hotwolf/S12G-Micro-EVB/RevB/S12G-Micro-EVB RevB Schematic.pdf

A

A

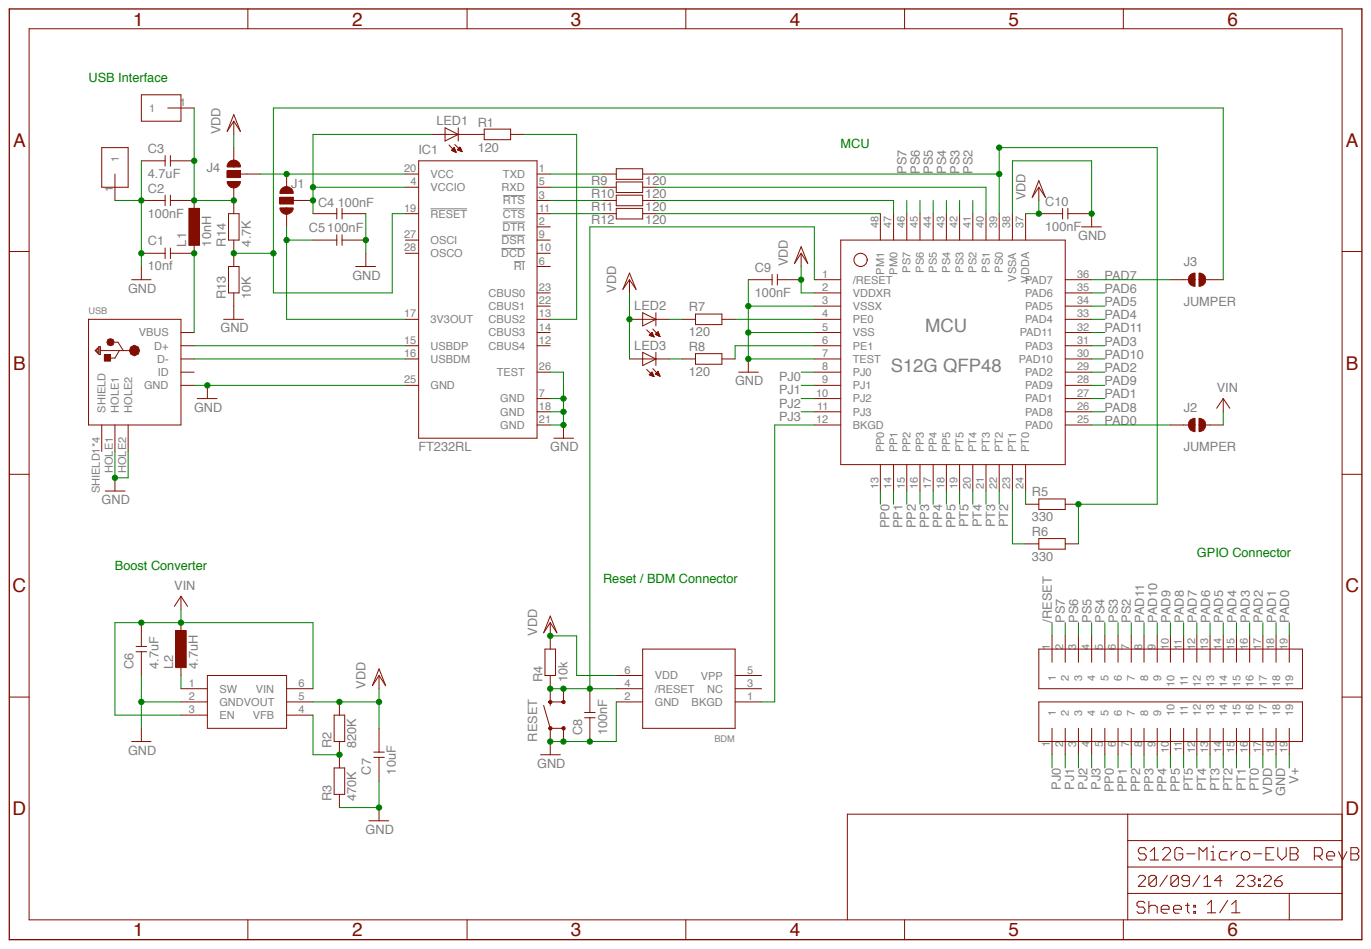
[picture p1: page 1]
