hotwolf/S12G-Micro-EVB/RevB/S12G-Micro-EVB RevB Mounting Plan.pdf

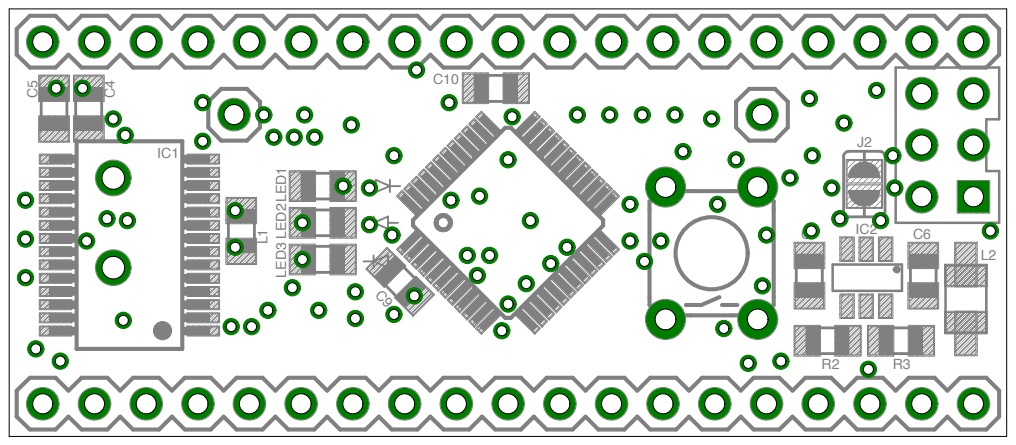
[picture p2: page 1]

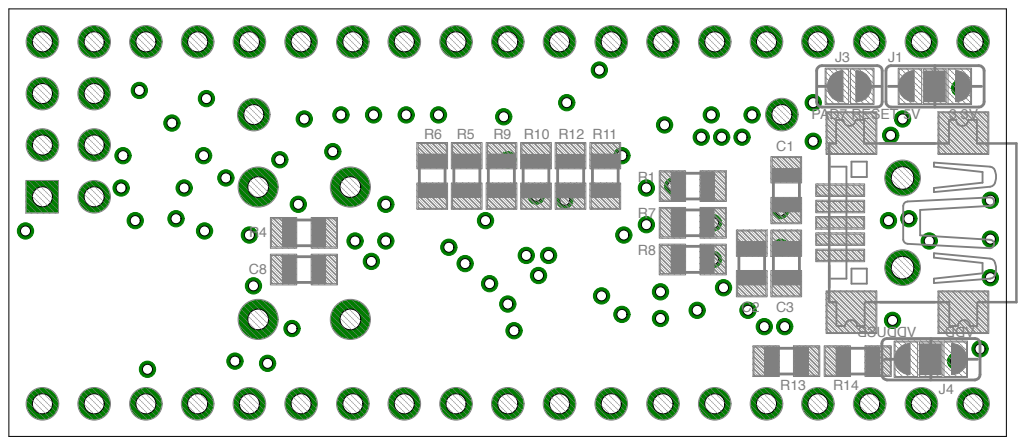
[picture p3: page 2]
