hotwolf/S12G-Micro-EVB/RevA/S12G-Micro-EVB RevA Schematic.pdf

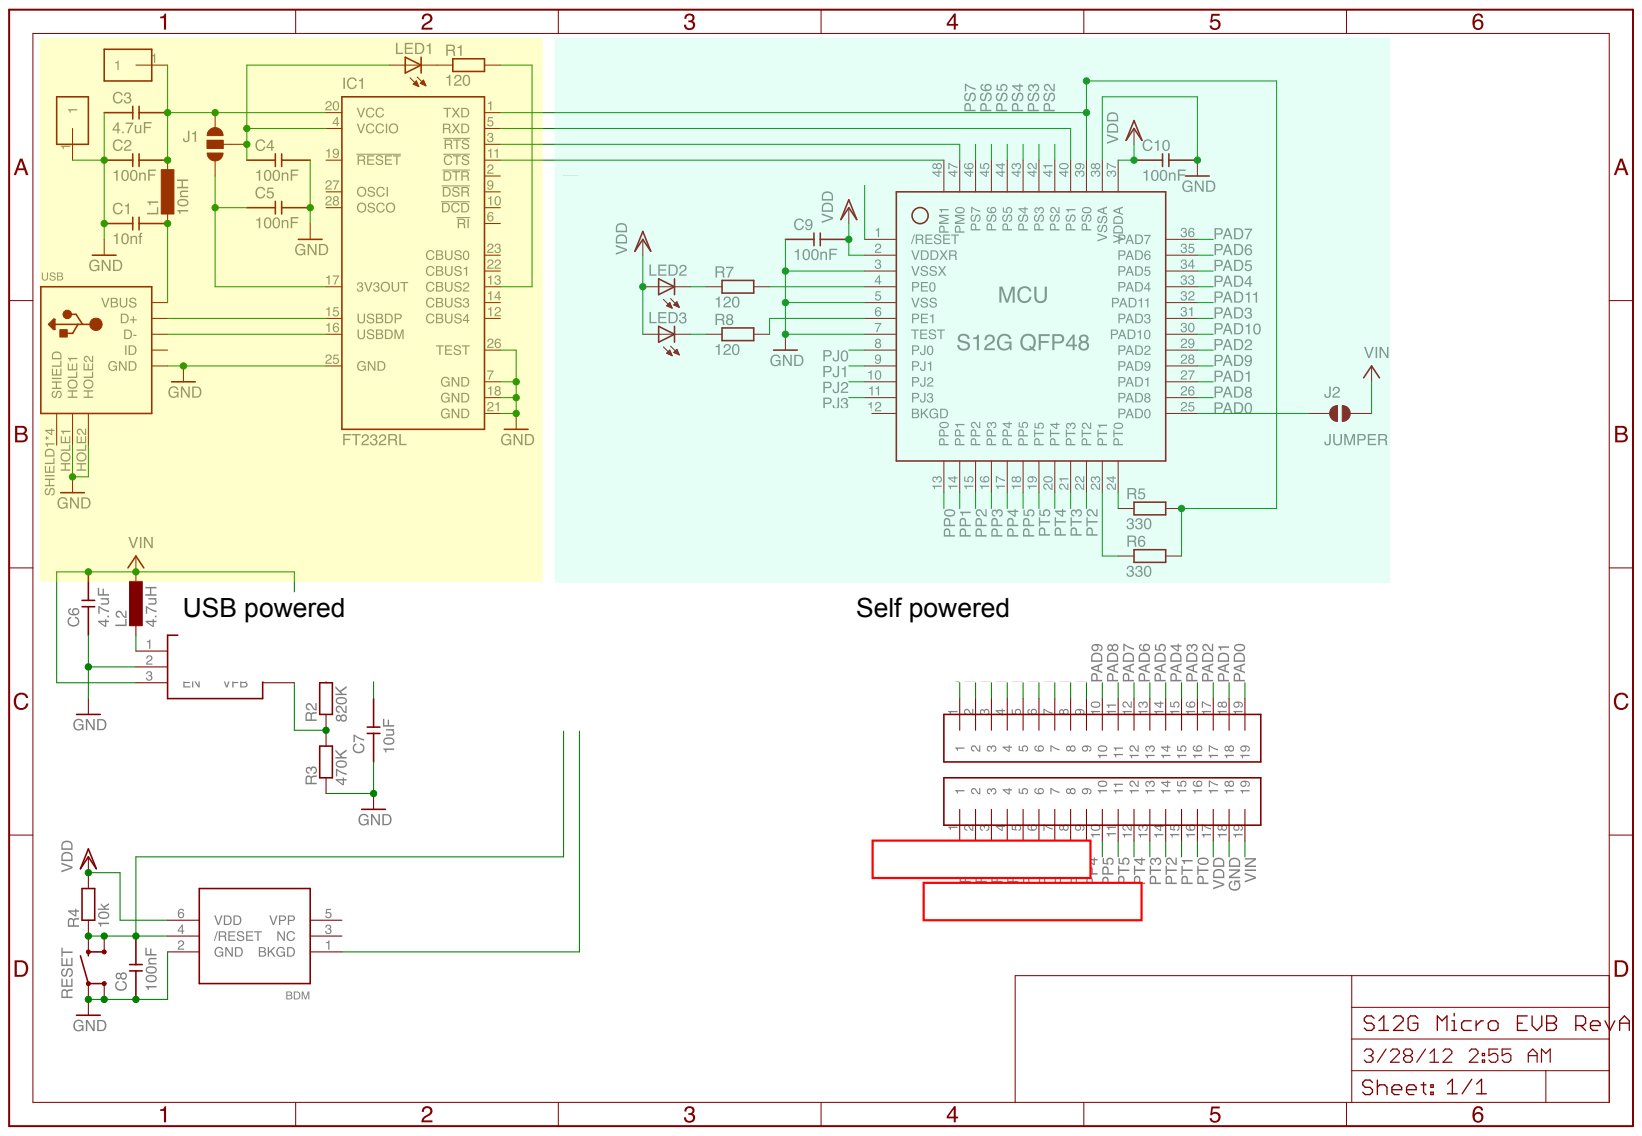
[picture p4: page 1]
