hotwolf/S12G-Micro-EVB/RevA/S12G-Micro-EVB RevA Mounting Plan.pdf

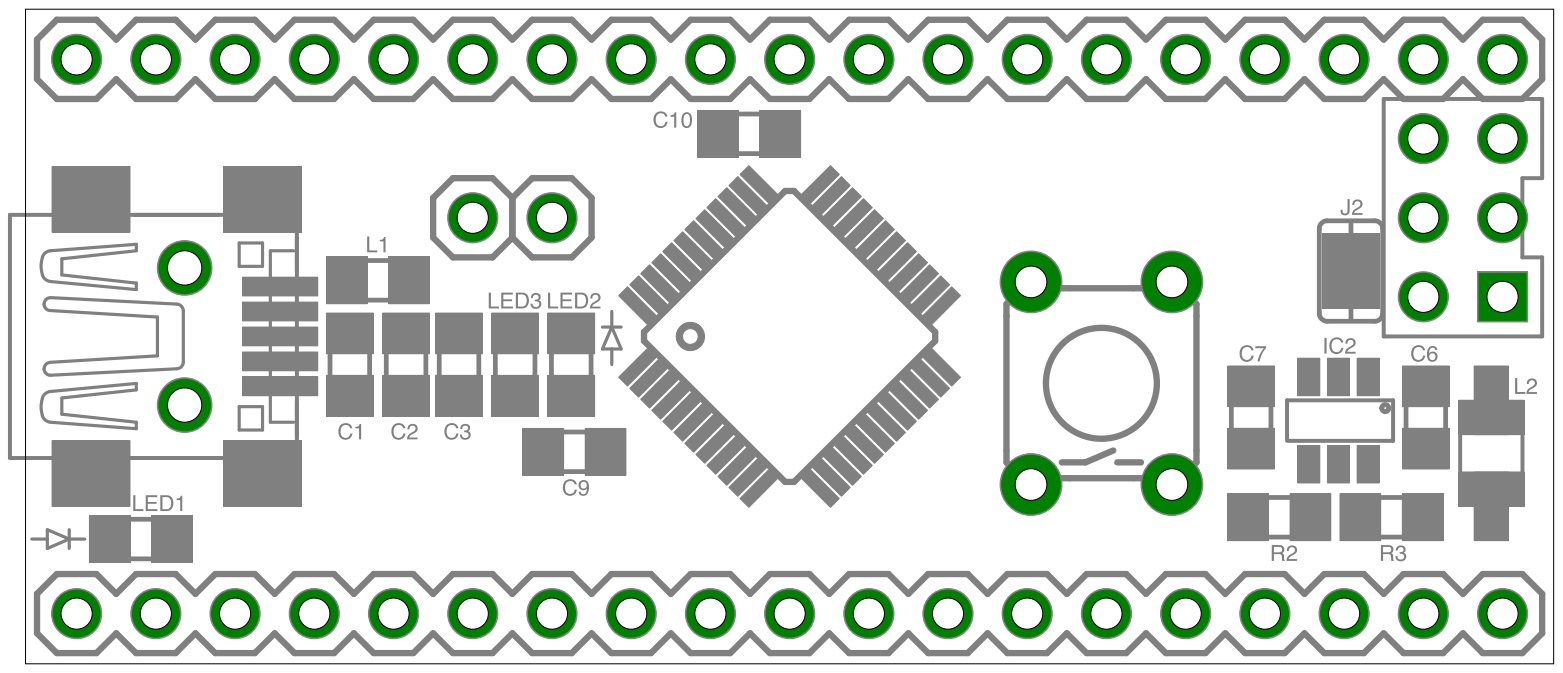
[picture p5: page 1]

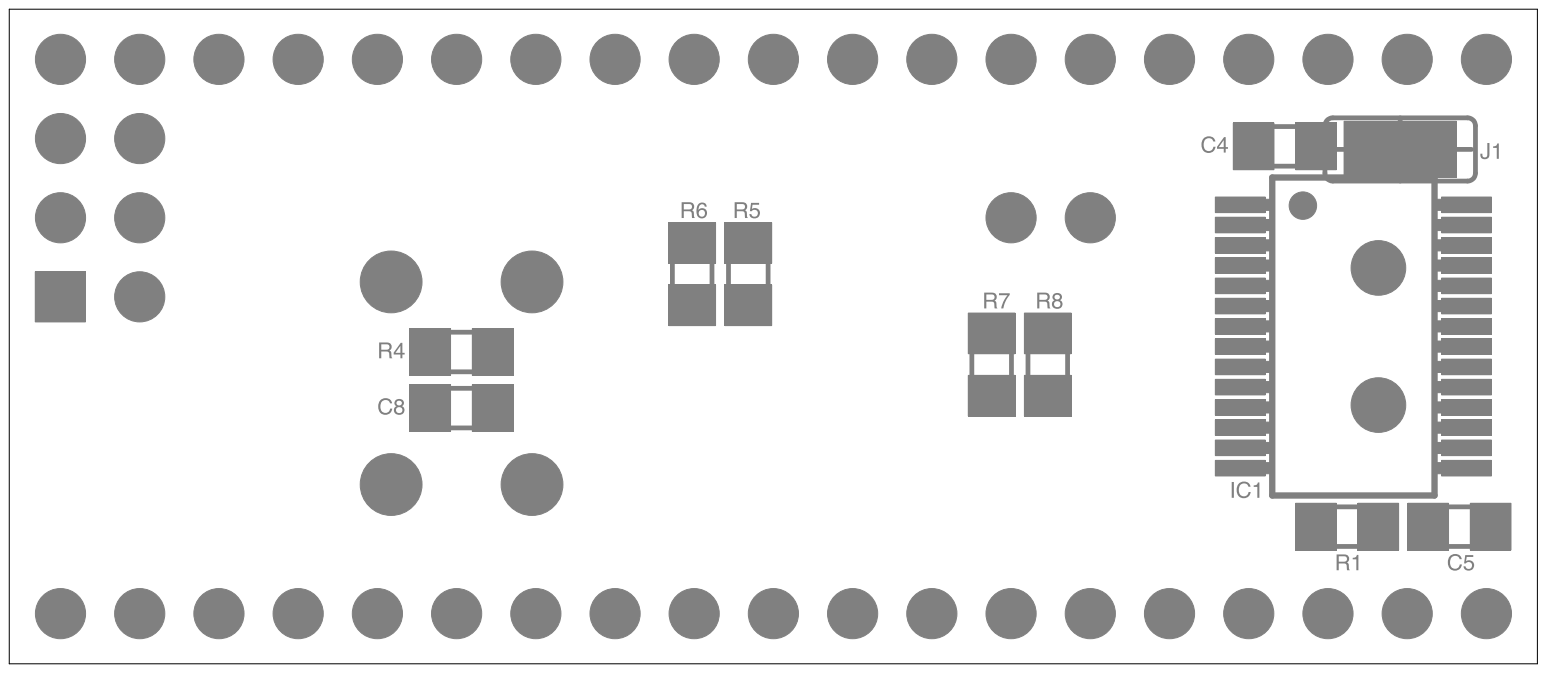
[picture p6: page 2]
