hotwolf/S12G-Micro-EVB/RevB/S12G-Micro-EVB RevB.brd

## EAGLE design RevB/S12G-Micro-EVB RevB.brd (2014-09-19)

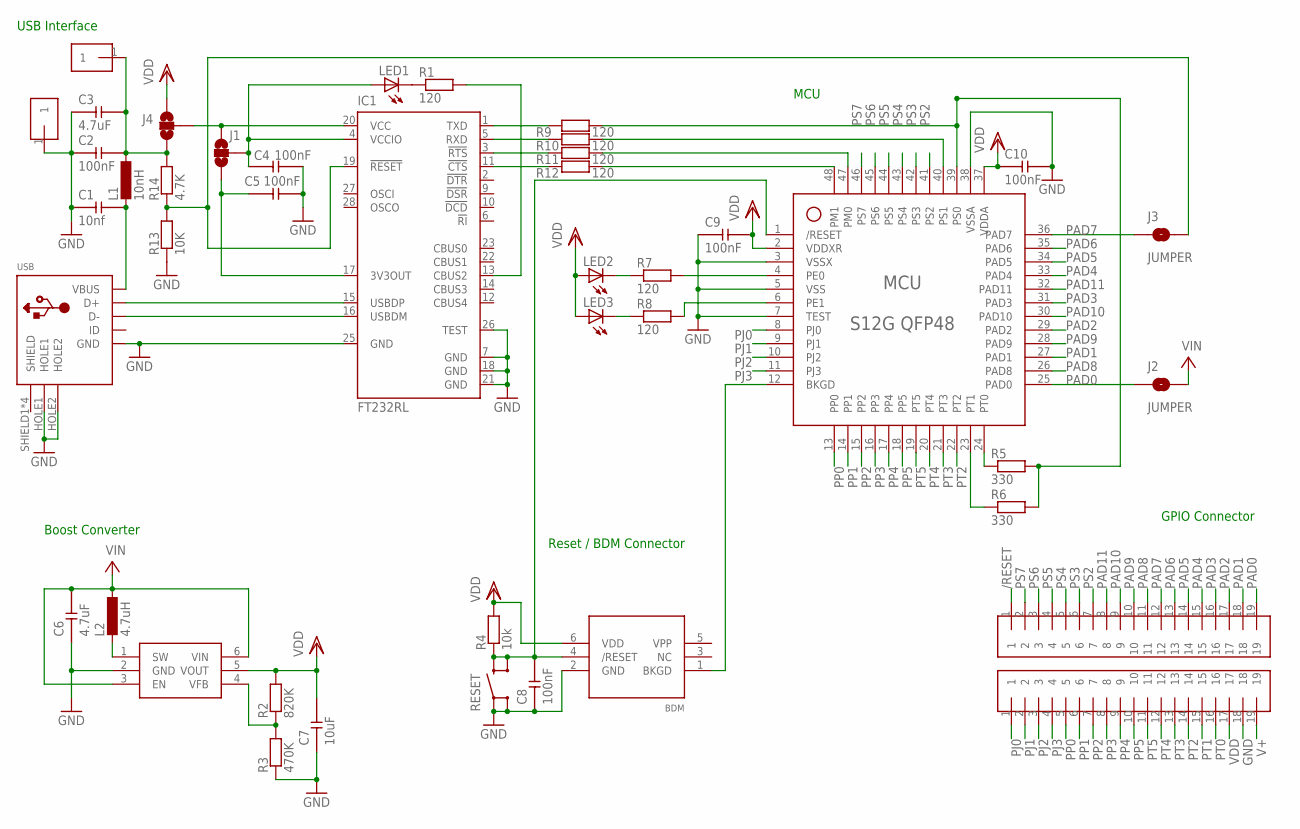
[picture p7: schematic S12G-Micro-EVB RevB.sch]

Parts:
BDM: BDM
BOTTOM: 1X19
C1: 10nf; 0805
C2, C4, C5, C8, C9, C10: 100nF; 0805
C3, C6: 4.7uF; 0805
C7: 10uF; 0805
GND: 1X1
IC1: FT232RL; SSOP28
IC2: MCP1640; SOT23-6
J1, J4: JUMPER_2WAY
J2, J3: JUMPER
L1: 10nH; 0805
L2: 4.7uH; LQH3C@1
LED1, LED2, LED3: LED0805; 0805
MCU: S12G QFP48; QFP44
R1, R7, R8, R9, R10, R11, R12: 120; 0805
R2: 820K; 0805
R3: 470K; 0805
R4: 10k; 0805
R5, R6: 330; 0805
R13: 10K; 0805
R14: 4.7K; 0805
RESET: BUTTON
TOP: 1X19
USB: USB; USB_MINI_B
VUSB: 1X1

Connections:
3V3OUT: C5.2, IC1.17 (3V3OUT), J1.3
/RESET: BDM.4 (/RESET), C8.1, MCU.1 (/RESET), R4.2, RESET.2, RESET.4, TOP.1
BKGD: BDM.1 (BKGD), MCU.12 (BKGD)
CBUS2: IC1.13 (CBUS2), R1.1
CTS: MCU.48 (PM1), R12.1
CTS_FT232RL: IC1.11 (!CTS), R12.2
GND: BDM.2 (GND), BOTTOM.18, C1.2, C2.2, C3.2, C4.1, C5.1, C6.2, C7.2, C8.2, C9.2, C10.1, GND.1, IC1.7 (GND), IC1.18 (GND), IC1.21 (GND), IC1.25 (GND), IC1.26 (TEST), IC2.2 (GND), MCU.3 (VSSX), MCU.5 (VSS), MCU.7 (TEST), MCU.38 (VSSA), R3.2, R13.2, RESET.1, RESET.3, USB.GND, USB.HOLE1, USB.HOLE2
unnamed: LED3.2 (C), R8.2
unnamed: IC2.4 (VFB), R2.2, R3.1
unnamed: LED2.2 (C), R7.2
unnamed: IC1.19 (!RESET), J3.2, R13.1, R14.2
unnamed: LED1.2 (C), R1.2
unnamed: IC2.1 (SW), L2.3 (2), L2.4 (2)
PAD0: J2.1, MCU.25 (PAD0), TOP.19
PAD1: MCU.27 (PAD1), TOP.18
PAD2: MCU.29 (PAD2), TOP.17
PAD3: MCU.31 (PAD3), TOP.16
PAD4: MCU.33 (PAD4), TOP.15
PAD5: MCU.34 (PAD5), TOP.14
PAD6: MCU.35 (PAD6), TOP.13
PAD7: J3.1, MCU.36 (PAD7), TOP.12
PAD8: MCU.26 (PAD8), TOP.11
PAD9: MCU.28 (PAD9), TOP.10
PAD10: MCU.30 (PAD10), TOP.9
PAD11: MCU.32 (PAD11), TOP.8
PE0: MCU.4 (PE0), R7.1
PE1: MCU.6 (PE1), R8.1
PJ0: BOTTOM.1, MCU.8 (PJ0)
PJ1: BOTTOM.2, MCU.9 (PJ1)
PJ2: BOTTOM.3, MCU.10 (PJ2)
PJ3: BOTTOM.4, MCU.11 (PJ3)
PP0: BOTTOM.5, MCU.13 (PP0)
PP1: BOTTOM.6, MCU.14 (PP1)
PP2: BOTTOM.7, MCU.15 (PP2)
PP3: BOTTOM.8, MCU.16 (PP3)
PP4: BOTTOM.9, MCU.17 (PP4)
PP5: BOTTOM.10, MCU.18 (PP5)
PS2: MCU.41 (PS2), TOP.7
PS3: MCU.42 (PS3), TOP.6
PS4: MCU.43 (PS4), TOP.5
PS5: MCU.44 (PS5), TOP.4
PS6: MCU.45 (PS6), TOP.3
PS7: MCU.46 (PS7), TOP.2
PT0: BOTTOM.16, MCU.24 (PT0), R5.2
PT1: BOTTOM.15, MCU.23 (PT1), R6.2
PT2: BOTTOM.14, MCU.22 (PT2)
PT3: BOTTOM.13, MCU.21 (PT3)
PT4: BOTTOM.12, MCU.20 (PT4)
PT5: BOTTOM.11, MCU.19 (PT5)
RTS: MCU.47 (PM0), R11.1
RTS_FT232RL: IC1.3 (!RTS), R11.2
RXD: MCU.39 (PS0), R5.1, R6.1, R9.1
RXD_FT232RL: IC1.5 (RXD), R10.2
SHIELD: USB.SHIELD1 (SHIELD), USB.SHIELD2 (SHIELD), USB.SHIELD3 (SHIELD), USB.SHIELD4 (SHIELD)
TXD: MCU.40 (PS1), R10.1
TXD_FT232RL: IC1.1 (TXD), R9.2
USBDN: IC1.16 (USBDM), USB.D-
USBDP: IC1.15 (USBDP), USB.D+
V+: BOTTOM.19, C6.1, IC2.3 (EN), IC2.6 (VIN), J2.2, L2.1, L2.5 (1)
VBUS: C1.1, L1.2, USB.VBUS
VCC: IC1.20 (VCC), J1.1, J4.2
VCCIO: C4.2, IC1.4 (VCCIO), J1.2, LED1.1 (A)
VDD: BDM.6 (VDD), BOTTOM.17, C7.1, C9.1, C10.2, IC2.5 (VOUT), J4.1, LED2.1 (A), LED3.1 (A), MCU.2 (VDDXR), MCU.37 (VDDA), R2.1, R4.1
VDDUSB: C2.1, C3.1, J4.3, L1.1, R14.1, VUSB.1

Notes on the sheet:
Boost Converter
USB Interface
MCU
Reset / BDM Connector
GPIO Connector

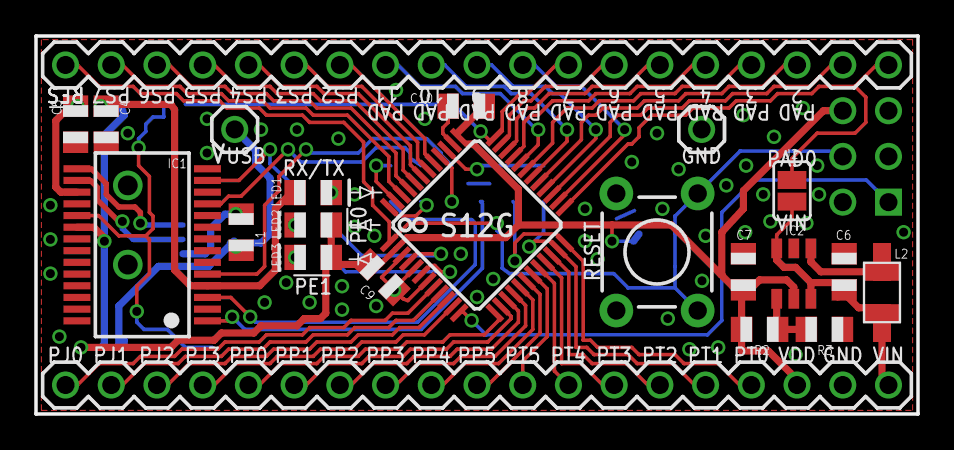
[picture p8: board S12G-Micro-EVB RevB.brd from above]

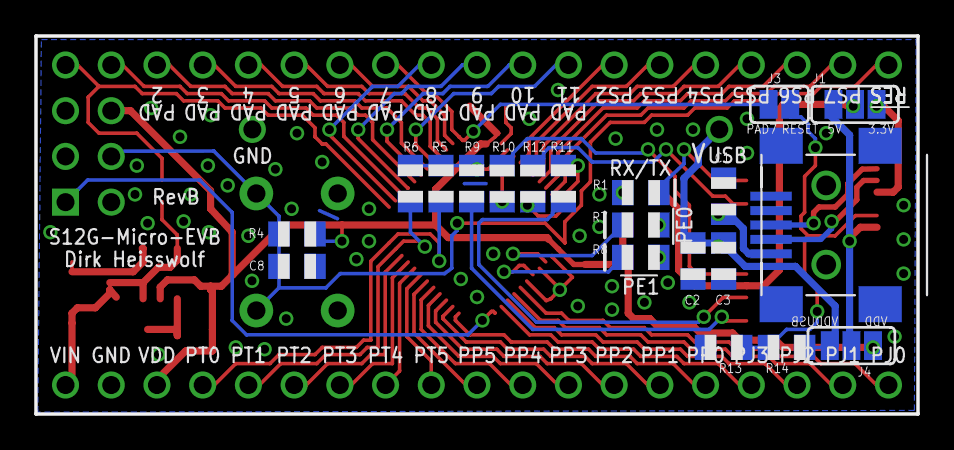
[picture p9: board S12G-Micro-EVB RevB.brd from below]

Board: 2 copper layers, 49.0 x 21.0 mm, 43 parts (20 on the bottom side), 64 nets.
