hotwolf/S12G-Micro-EVB/(commit log)

2012-03-25 initial release (Rev. A)
    [S12G Micro EVB RevA.brd, S12G Micro EVB RevA.sch]
2012-03-27 added BOM
    [S12G Micro EVB RevA.brd, S12G Micro EVB RevA.sch]
2012-03-28 added schematic and mounting plan
    [S12G Micro EVB RevA.brd]
2012-04-02 corrected BOM
2012-04-16 fixed BOM
2014-09-01 started RevB board
    [S12G Micro EVB RevB.brd, S12G Micro EVB RevB.sch]
2014-09-18 finished RevB layout
    [S12G Micro EVB RevA.brd, S12G Micro EVB RevA.sch, S12G Micro EVB RevB.brd, S12G Micro EVB RevB.sch]
2014-09-18 fixed file names
    [S12G Micro EVB RevB.brd, S12G Micro EVB RevB.sch, S12G-Micro-EVB RevA.brd, S12G-Micro-EVB RevA.sch]
2014-09-18 added Gerber files
2014-09-18 added mounting plan
2014-09-19 added RevB BOM
    [S12G-Micro-EVB RevB.brd, S12G-Micro-EVB RevB.sch]
2014-11-03 minor fix in BOM files
2015-12-26 Update S12G-Micro-EVB RevB BOM.txt
